Paul-3400/fibonacci-ping-pong-clock/(commit log)

2026-10-18 Initial: Bauanleitung Fibonacci Ping-Pong-Ball-Uhr (40 Bälle, 8×5-Raster), README und GPL-2.0-Lizenz
2026-10-18 Wokwi-Prototyp: XIAO ESP32-S3, 40 NeoPixel im 8x5-Raster (Daisy-Chain), TM1637, NTP – sketch.ino, diagram.json, libraries.txt
2026-10-20 Demo-Variante wokwidemo: 5 Taster (Felder A-E, Handbetrieb +1min/+5min/+1h, Normalbetrieb) – sketch, diagram, libraries
2026-10-20 Demo-Variante 2 (wokwidemo2): Schnecken-Layout 5x8 hochkant (Nerdiy-Anordnung) mit gleichen 5 Tastern – sketch, diagram, libraries
2026-10-20 wokwidemo2: Feld-Anordnung korrigiert – C unten rechts (np33/np34/np38/np39), D/E darüber (np28/np29) = echte oeffnende Fibonacci-Schnecke
    [sketch.ino]
2026-10-20 chore: alte 8x5-Demo entfernen (wird als Schnecken-Demo neu aufgebaut)
2026-10-20 chore: wokwidemo2 aufloesen – Inhalt wird als wokwidemo neu gepusht (sketch.ino)
2026-10-20 chore: wokwidemo2 aufloesen – Inhalt wird als wokwidemo neu gepusht (diagram.json)
2026-10-20 chore: wokwidemo2 aufloesen – Inhalt wird als wokwidemo neu gepusht (libraries.txt)
2026-10-20 chore: wokwidemo2 aufloesen – Inhalt wird als wokwidemo neu gepusht (README.md)
2026-10-20 README: Projektuebersicht auf 5x8-Schnecken-Layout + 5 Taster und neue Ordnerstruktur
2026-10-21 docs: Bauanleitung – 5V-Stromversorgung, Zwei-Gehauese-Konzept (Steuerbox + Anzeigebox), Datenblatt-Verweise
2026-10-21 docs: Steckverbinder hinterlegt – DC-Buchse 5,5x2,1 mm (5V-Zuleitung) + GX12-Kupplungspaar 4-polig (Verbindungskabel)
2026-10-21 docs: Base4-Modus von Beginn integriert – Kippschalter GPIO 26 (Fibonacci<->Base4), 3x3-Matrix in Feld A, base4.py + Code-Entwuerfe erweitert
2026-11-07 docs: Unterlagen an die reale Anzeigetafel angepasst (B/C gespiegelt: B=Spalten C-E, C=Spalten A-B, D=A5, E=B5; Daten- und Stromkette spaltenweise, LED=Spalte*8+Zeile)
2026-11-07 docs: Modus-Umschalter als 6. Taster (T6) statt Kippschalter (nur Momentary-Taster an Lager; gleiche Verdrahtung GPIO 26 gegen GND, Software-Toggle pro Druck)
2026-11-08 docs: OS auf Raspberry Pi OS Trixie Lite (32-bit) umgestellt (PEP-668-venv, /boot/firmware/config.txt, systemd startet venv-Python)
2026-11-08 feat: Python-Module eingecheckt (config, mapping, buttons, fibonacci, base4, display, tm1637_display, ntp_time, main); docs: Setup korrigiert (git clone, Pfade Benutzer paul-rppi statt pi, Fallstrick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
    [base4.py, buttons.py, config.py, display.py, fibonacci.py, main.py, mapping.py, ntp_time.py]
2026-11-08 feat: Steuerbox-Selbsttest steuerbox_test.py (Uhr HH:MM:SS + Tastenpruefung, ohne Clone nutzbar); fix: tm1637_display auf write()/encode umgestellt (Library ist 4-stellig: show() max. 4 Zeichen, clea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
    [steuerbox_test.py, tm1637_display.py]
2026-11-08 docs: git für Raspberry Pi OS Lite nachinstallieren (Fallstrick 26, Kap. 8 + README-Setup); venv-Dauer-Hinweis Pi Zero; Selbsttest bestanden dokumentiert (HH:MM:SS + T1-T6); README-Quelle depklyon
2026-11-08 fix: Start-Bugs config.py – LED_BRIGHTNESS int 102 statt Float 0.4 (SWIG uint8_t lehnt Floats ab, TypeError bei main.py); LED_STRIP_TYPE = ws.WS2811_STRIP_GRB 0x00081000 statt Arduino-Wert 0x00081008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
    [config.py]
2026-11-09 feat: anzeige_test.py (T6=Anzeige ein/aus, Demo: 5 Felder in Farben, T1-T5=Einzelfelder, TM1637 zeigt Wert-Summe); fix: fibonacci.py COMBINATIONS auf mapping.FELDER-Indizes umgestellt (vorher 0-4=[1,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
    [anzeige_test.py, fibonacci.py]
2026-11-09 fix: Soft-Start-Rampe in main.py (Helligkeit 20 -> LED_BRIGHTNESS in ~40s) gegen Last-Spitzen beim Start (Absturz 09.11.2026 um 10:04: Minuten 0-4 -> sofort alle 40 LEDs, Pi+Tafel am selben Netzteil 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
    [config.py, main.py]
2026-11-09 fix: NTP-Auswertung behoben (Fallstrick 30) - sync_ntp() verwendete die NTP-Antwort nicht, die Uhr lief still auf der ungesyncten Systemzeit; get_local_time() rechnet jetzt aus der NTP-Referenz (resp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
    [ntp_time.py]
2026-11-09 fix: TM1637-Ziffernpaare-Fix (Fallstrick 31) - 6-stelliges Modul vertauscht Paar 1/2, zeigte MM:HH:SS statt HH:MM:SS (beobachtet: '33:13:50' = 13:33:50, Foto '04:14:45' = 14:04:45); _modul_segments()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
    [steuerbox_test.py, tm1637_display.py]
2026-11-10 docs: Stand 10.11.2026 nachfuehren - systemd-Autostart in Betrieb (Reboot-Test bestanden), Fahrplan erledigt; Fallstrick 31: Paarvertausch-Fix wirkungslos, TM1637-Bug offen
2026-11-10 fix: TM1637-Anzeige endgueltig korrigiert (Fallstrick 31) - Modul spiegelt die Segmentliste je Haelfte ('123456' -> '321654'), _modul_segments() kehrt 3er-Haelften um; Bauanleitung/README nachgezogen
    [steuerbox_test.py, tm1637_display.py]
2026-11-10 Doku: README - Link und Status zur Erweiterung Anzeige-Modi ergänzt
2026-11-10 Doku: Funktionstest main.py mit sudo (ws281x braucht root: ohne sudo ws2811_init -9 mailbox + Segfault) - Korrektur der Stufe-1-Testanweisung
2026-11-10 Stufe 2: Modus 3 (Binaerzaehler h/m/s, T3) und Modus 4 (grosse Ziffern, T4) mit font5x7.py; Log-Drossel in main.py; Doku: Stufe-1-Geraetebestaetigung + Stufe-2-Stand
2026-11-10 Fallstrick 33: Tafel spaltenweise gespiegelt an der Datenkette (Modus 4 zeigte Ziffern spiegelverkehrt) - display.py spiegelt die Spalte zentral (_PHYS_LED), anzeige_test.py + mapping.py-Kommentar na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
2026-11-11 Fix Fallstrick 34: YAML-Frontmatter der Bauanleitung repariert (Revision-Wert war mehrzeilig geraten -> GitHub-Parsing-Fehler 'did not find expected key'); Fallstrick 34 + Revision-Log dokumentiert
2026-11-11 Stufe 4: EierUhr-Fall-Animation (Korn C3/C4 je 150 ms, ms-Frame-Timing), Modus 9 Analog-Uhr, Modus 10 Pong-Uhr (deterministische Ballbahn, Scoreboard quer in 3x5-Font); ntp_time.get_local_time_precis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
